LelisSoares/M-dulo-Arrecadador/guia de montagem - quase completp (falta p. inertnas e móveis).pdf

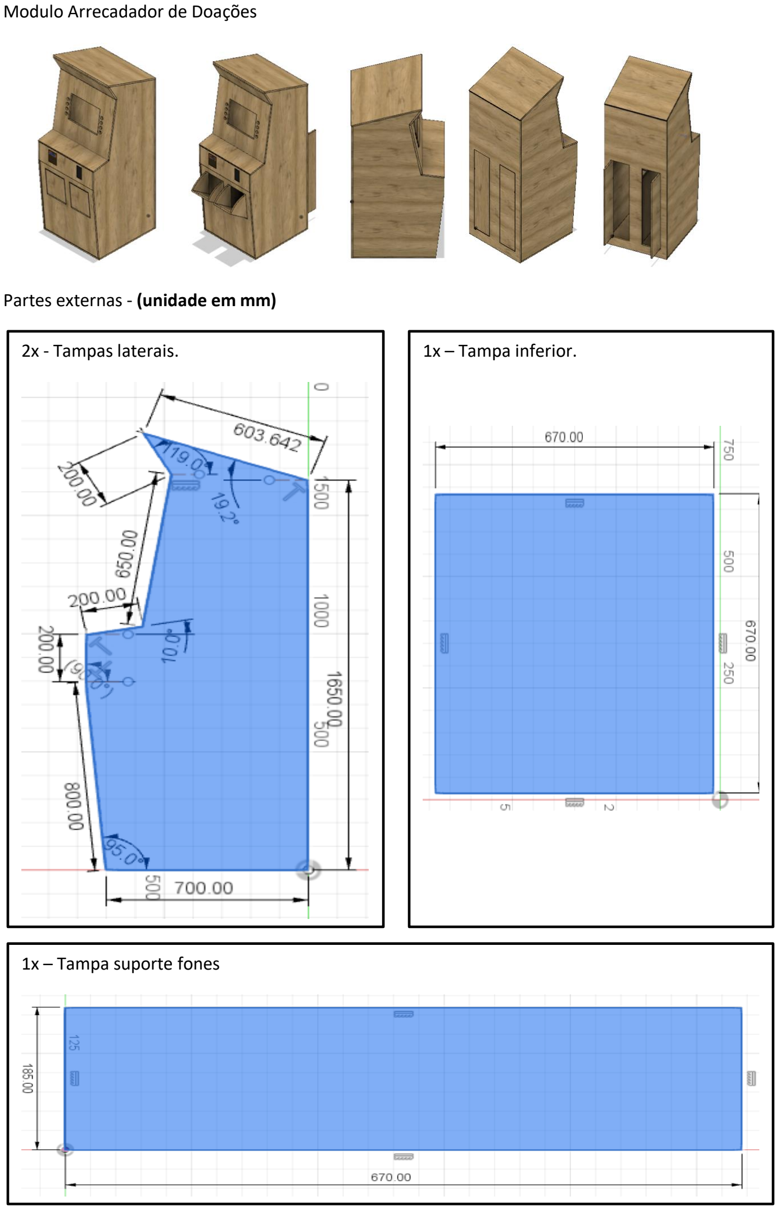
[picture p1: page 1]

Modulo Arrecadador de Doações

Partes externas - (unidade em mm)

2x - Tampas laterais. | 1x – Tampa inferior.

1x – Tampa suporte fones

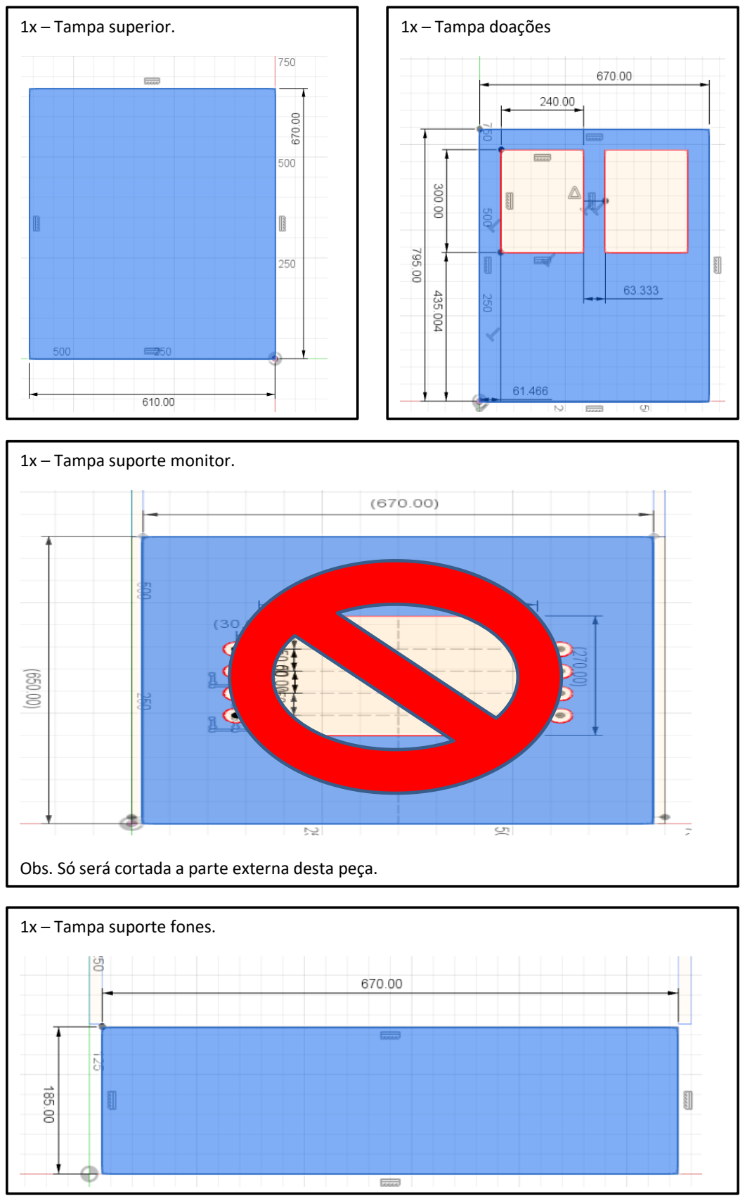
[picture p2: page 2]

1x – Tampa superior. | 1x – Tampa doações

1x – Tampa suporte monitor.

Obs. Só será cortada a parte externa desta peça.

1x – Tampa suporte fones.

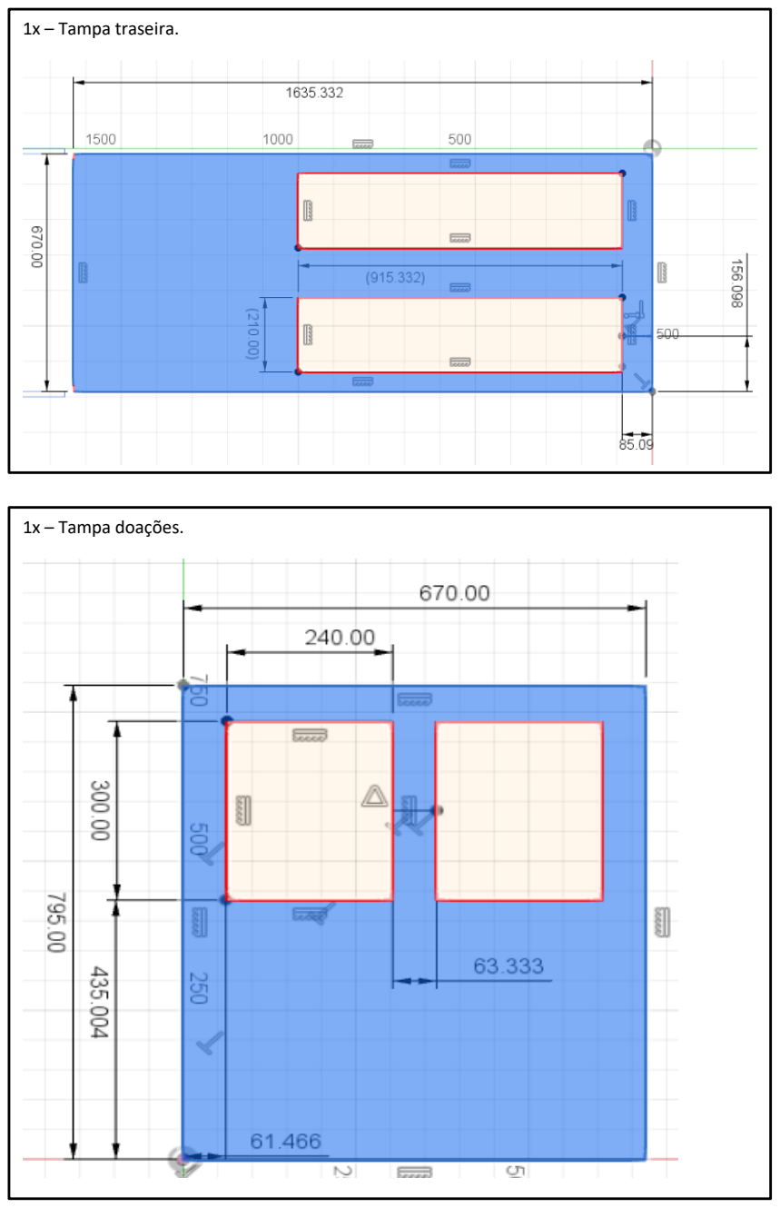
[picture p3: page 3]

1x – Tampa traseira.

1x – Tampa doações.

1x – Tampa dispositivos monetários

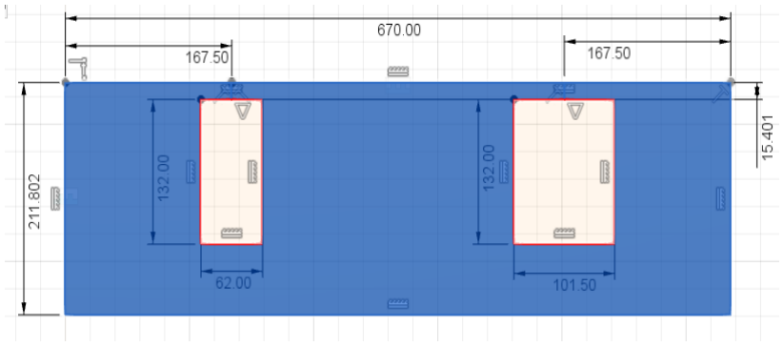
[picture p4: figure]

1x – Tampa apoio de mãos.

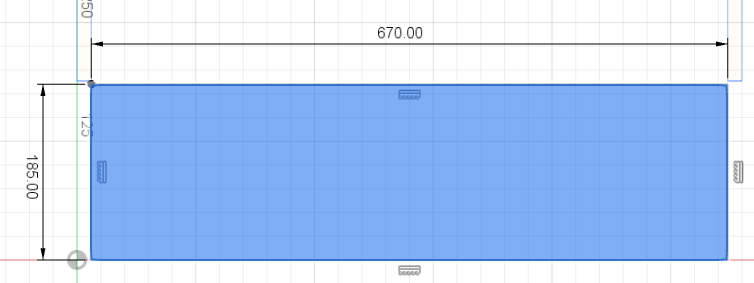
[picture p5: figure]
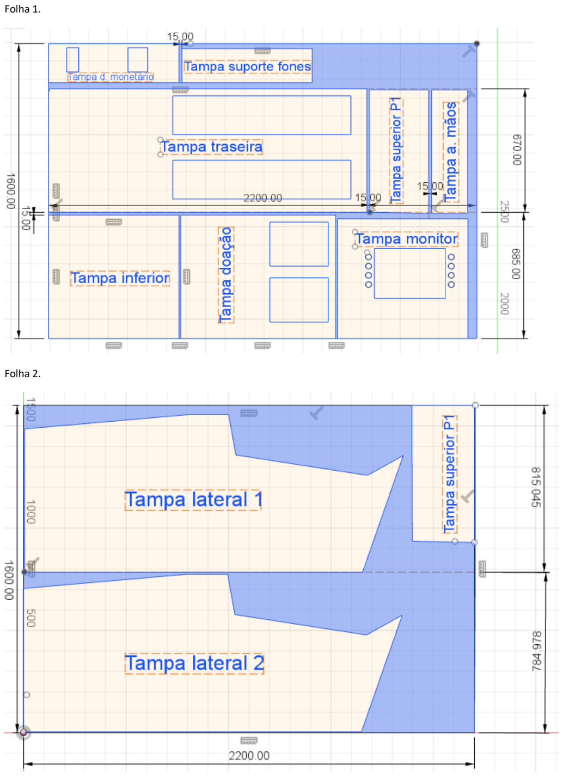
[picture p6: page 5]

Folha 1.

Folha 2.
